WegenerPiat/stm32f4-energy-monitor/proto_mesure/liste_composant.ods

Nom du composant | Valeur | Information complémentaire | Quantité | Prix à l’unité | Prix total | Référence farnell | Référence Fabricant | Fabricant
Capacité | 100nF | traversant et ceramique | 3 | 0,1782 | 0,5346 | 1216440 | MCRR50104X7RK0050 | Multicomp
LED |  | 3mm | 1 | 0 | 0
Connecteur 01x05 |  | Barrette secable embase mâle (40 contacts) | 3 | 2,17 | 2,17 | 1098454 | 4-103321-8. | TE Connectivity
Bornier 01x05 |  | Pas 5.08 | 2 | 1,42 | 2,84 | 2008007 | MC000037 | Multicomp
Résistance | 680R | traversante | 1 | 0,0714 | 0,0714 | 9338926 | MCF 0.5W 680R | Multicomp
Shunt |  | 0.02 ohm (choix non definitif) | 4 | 3,17 | 12,68 | 2408840 | LVR03R0200FE12 | VISHAY
Shield NUCLEO |  |  | 1 | 13,36 | 13,36 | 2491978 | NUCLEO-F446RE | STMicroelectronics
MAX4377 |  | ampli diff. Gain : 20 | 2 | 2,63 | 5,26 | 2515271 | MAX4377TAUA+ | MAXIM
 |  |  |  | Prix final : | 36,916
