WegenerPiat/stm32f4-energy-monitor/(list of files, drawings)

Other design files:
proto_mesure/MB1136C_schematic_layout/Connectors.SchDoc
proto_mesure/MB1136C_schematic_layout/MB1136.PcbDoc
proto_mesure/MB1136C_schematic_layout/MB1136.PrjPCB
proto_mesure/MB1136C_schematic_layout/MB1136.SchDoc
proto_mesure/MB1136C_schematic_layout/MB1136.SCHLIB
proto_mesure/MB1136C_schematic_layout/MCU_64.SchDoc
proto_mesure/MB1136C_schematic_layout/ST_LINK_V2-1.SCHDOC
