WegenerPiat/stm32f4-energy-monitor/proto_mesure/kicad/carte_mesure.kicad_pcb

## KiCad design proto_mesure/kicad/carte_mesure.kicad_pcb (2016-08-31)

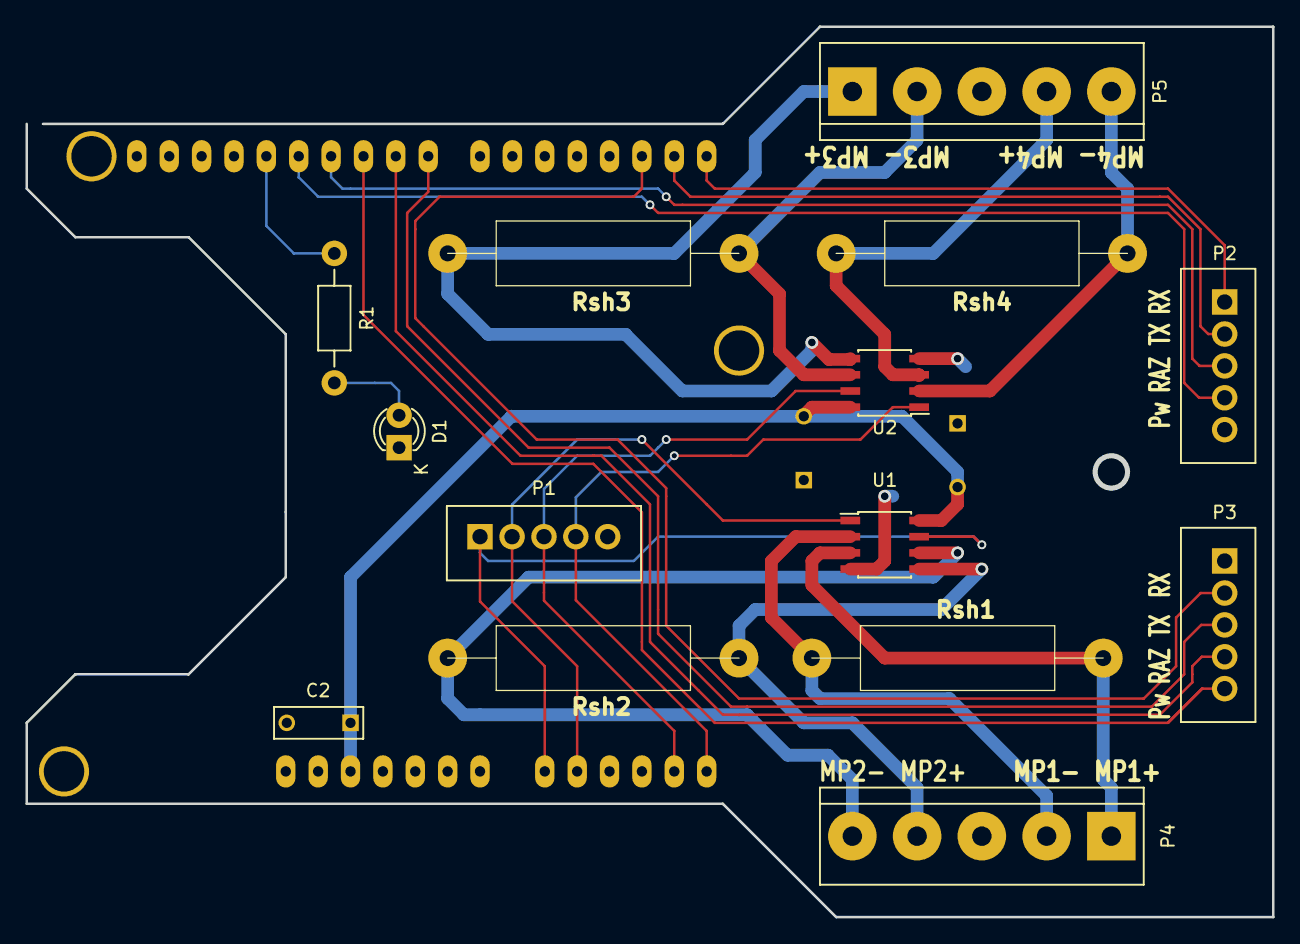
[picture p1: board carte_mesure.kicad_pcb from above]

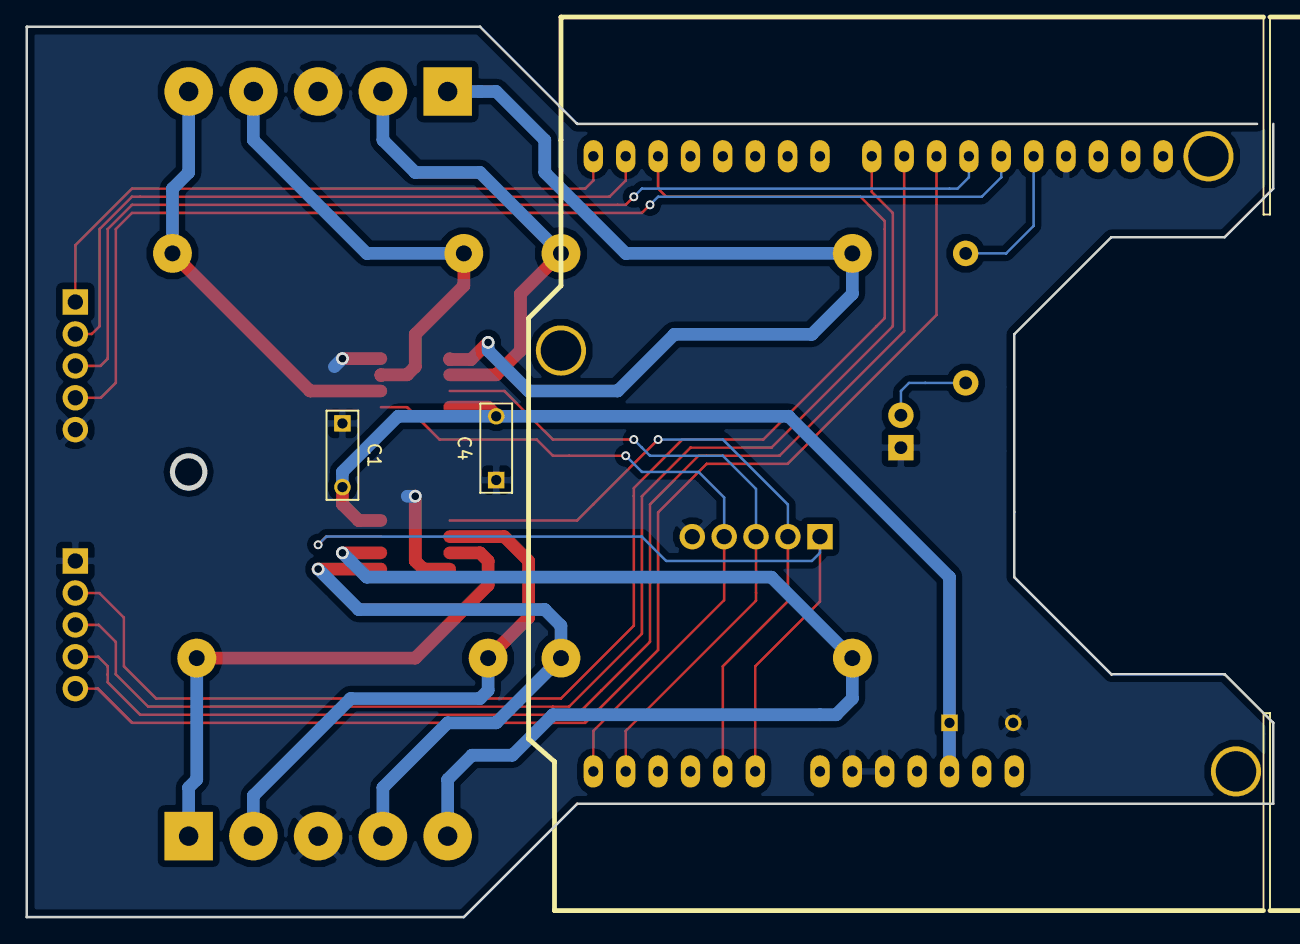
[picture p2: board carte_mesure.kicad_pcb from below]

Board: 2 copper layers, 97.8 x 69.8 mm, 17 parts (2 on the bottom side), 24 nets.

Parts:
C1, C2, C4: 100nF; C_Rect_L7_W2.5_P5
D1: LED; LED-3MM
P1, P2, P3: CONN_01X05; Wafer_Vertical15x5.8x7RM2.5-5
P4, P5: CONN_01X05; bornier5
R1: 680R; Resistor_Horizontal_RM10mm
Rsh1, Rsh2, Rsh3, Rsh4: Shunt; shunt
SHIELD1: ARDUINO_SHIELD_NUCLEO
U1, U2: MAX4377; SOIC-8_3.9x4.9mm_Pitch1.27mm

Connections:
+3V3: C1.2, C2.1, C4.2, SHIELD1.3V3, U1.8, U2.8
/carte_nucleo/MP_A1: P1.1, SHIELD1.AD0, U1.7
/carte_nucleo/MP_A2: P1.2, SHIELD1.AD1, U1.1
/carte_nucleo/MP_B1: P1.3, SHIELD1.AD4, U2.7
/carte_nucleo/MP_B2: P1.4, SHIELD1.AD5, U2.1
/carte_nucleo/PWD1: P2.4, SHIELD1.D12
/carte_nucleo/PWD2: P3.5, SHIELD1.D10
/carte_nucleo/RX1: P2.1, SHIELD1.D0
/carte_nucleo/RX2: P3.2, SHIELD1.D2
/carte_nucleo/Reset1: P2.3, SHIELD1.D11
/carte_nucleo/Reset2: P3.4, SHIELD1.D9
/carte_nucleo/TX1: P2.2, SHIELD1.D1
/carte_nucleo/TX2: P3.3, SHIELD1.D8
/conn_shunt1/MP1+: P4.1, Rsh1.+, U1.3
/conn_shunt1/MP1-: P4.2, Rsh1.-, U1.2
/conn_shunt1/MP2+: P4.4, Rsh2.+, U1.5
/conn_shunt1/MP2-: P4.5, Rsh2.-, U1.6
/conn_shunt_MES2/MP3+: P5.1, Rsh3.+, U2.5
/conn_shunt_MES2/MP3-: P5.2, Rsh3.-, U2.6
/conn_shunt_MES2/MP4+: P5.4, Rsh4.+, U2.3
/conn_shunt_MES2/MP4-: P5.5, Rsh4.-, U2.2
GND: C1.1, C2.2, C4.1, D1.1, P1.5, P2.5, P3.1, P4.3, P5.3, SHIELD1.GND1, SHIELD1.GND2, SHIELD1.GND3, U1.4, U2.4
unnamed: D1.2, R1.2
unnamed: R1.1, SHIELD1.D13
