WegenerPiat/stm32f4-energy-monitor/firmware/src/energy_monitor.c

#include <stdlib.h>
#include <libopencm3/stm32/rcc.h>
#include <libopencm3/stm32/gpio.h>
#include <libopencm3/stm32/adc.h>
#include <libopencm3/stm32/timer.h>
#include <libopencm3/usb/usbd.h>
#include <libopencm3/usb/cdc.h>
#include <libopencm3/cm3/scb.h>
#include <libopencm3/cm3/nvic.h>
#include <libopencm3/cm3/systick.h>
#include <libopencm3/stm32/dma.h>
#include <libopencm3/stm32/flash.h>
#include <libopencm3/stm32/exti.h>
#include <libopencm3/stm32/pwr.h>

// USB Code

static const struct usb_device_descriptor dev = {
    .bLength = USB_DT_DEVICE_SIZE,
    .bDescriptorType = USB_DT_DEVICE,
    .bcdUSB = 0x0200,
    .bDeviceClass = 0,
    .bDeviceSubClass = 0,
    .bDeviceProtocol = 0,
    .bMaxPacketSize0 = 64,
    .idVendor = 0xF539,
    .idProduct = 0xF539,
    .bcdDevice = 0x0200,
    .iManufacturer = 1,
    .iProduct = 2,
    .iSerialNumber = 3,
    .bNumConfigurations = 1,
};


static const struct usb_endpoint_descriptor data_endp[] = {{
    .bLength = USB_DT_ENDPOINT_SIZE,
    .bDescriptorType = USB_DT_ENDPOINT,
    .bEndpointAddress = 0x81,
    .bmAttributes = USB_ENDPOINT_ATTR_BULK,
    .wMaxPacketSize = 64,
    .bInterval = 1,
}, {
    .bLength = USB_DT_ENDPOINT_SIZE,
    .bDescriptorType = USB_DT_ENDPOINT,
    .bEndpointAddress = 0x82,
    .bmAttributes = USB_ENDPOINT_ATTR_INTERRUPT,
    .wMaxPacketSize = 64,
    .bInterval = 1,
}};

static const struct usb_interface_descriptor data_iface[] = {{
    .bLength = USB_DT_INTERFACE_SIZE,
    .bDescriptorType = USB_DT_INTERFACE,
    .bInterfaceNumber = 0,
    .bAlternateSetting = 0,
    .bNumEndpoints = 2,
    .bInterfaceClass = 0xFF,
    .bInterfaceSubClass = 0,
    .bInterfaceProtocol = 0,
    .iInterface = 2,

    .endpoint = data_endp,
}};

static const struct usb_interface ifaces[] = {{
    .num_altsetting = 1,
    .altsetting = data_iface,
}};

static const struct usb_config_descriptor config = {
    .bLength = USB_DT_CONFIGURATION_SIZE,
    .bDescriptorType = USB_DT_CONFIGURATION,
    .wTotalLength = 0,
    .bNumInterfaces = 1,
    .bConfigurationValue = 1,
    .iConfiguration = 0,
    .bmAttributes = 0x80,
    .bMaxPower = 0x32,

    .interface = ifaces,
};

static const char *serial_str = (const char*)0x08004000;

static const char *usb_strings[] = {
    "James Pallister",
    "Medium speed energy monitor",
    0x08004000,
};

void adc_setup();
void error_condition();

// Power data ///////////////////////////////////////////////////////

#define INSTANT_AVG_BITS    5
#define INSTANT_AVG_NUM     (1<<INSTANT_AVG_BITS)
#define SIZE_BUFF 			50			//taille du buffer

typedef struct {
    uint64_t energy_accum;
    uint64_t elapsed_time;
    unsigned peak_power;
    unsigned peak_voltage;
    unsigned peak_current;
    unsigned n_samples;
    uint64_t test_tension;
    uint64_t avg_voltage;
} accumulated_data;

typedef struct {
    unsigned voltage;
    unsigned current;

    uint64_t current_time;    
} instant_data;

int tperiod=500;

typedef struct {
    accumulated_data accum_data;
    instant_data id;


    int idx;
    int running; // Are we collecting measurements
    int number_of_runs;

    // Implement a circular buffer in data_bufs
    int trigger_port, trigger_pin;

    int assigned_adc;

    unsigned short lastI, lastV;
    unsigned lastP;

    unsigned short avgI[INSTANT_AVG_NUM], avgV[INSTANT_AVG_NUM];
    unsigned short avg_ptr;

    unsigned char chans[1];
} measurement_point;

/////////buffer circulaire/////////
typedef struct {	
	uint64_t *buffer_complete;		//totalite du buffer
	uint64_t *read_bc;				//pointeur de lecture
	uint64_t *write_bc;				//pointeur d ecriture
	
	uint64_t *debut;				//pointeur de debut
	uint64_t *fin;					//pointeur de fin

	int nb_read;					//nombre de donnee envoyee
	int nb_write;					//nombre de donnee ecrite
} buff;

measurement_point m_points[4] = {0};
buff bc;

int adc_to_mpoint[3] = {-1, -1, -1};

// USB communication globals ////////////////////////////////////////
usbd_device *usbd_dev;

uint8_t control_buffer[128] __attribute__((aligned (16)));

unsigned versionNumber=14;

/////////////////////////////////////////////////////////////////////

void exti_setup(int m_point)
{
    int i;

    nvic_disable_irq(NVIC_EXTI0_IRQ);
    nvic_disable_irq(NVIC_EXTI1_IRQ);
    nvic_disable_irq(NVIC_EXTI2_IRQ);
    nvic_disable_irq(NVIC_EXTI3_IRQ);
    nvic_disable_irq(NVIC_EXTI4_IRQ);
    nvic_disable_irq(NVIC_EXTI9_5_IRQ);
    nvic_disable_irq(NVIC_EXTI15_10_IRQ);
    exti_reset_request(EXTI0 | EXTI1 | EXTI2 | EXTI3 | EXTI4 | EXTI5 | EXTI6  | EXTI7
            | EXTI8 | EXTI9 | EXTI10 | EXTI11 | EXTI12 | EXTI13 | EXTI14  | EXTI15);

    for(i = 0; i < 4; ++i)
    {
        exti_select_source(m_points[i].trigger_pin, m_points[i].trigger_port);
        exti_set_trigger(m_points[i].trigger_pin, EXTI_TRIGGER_BOTH);
        exti_enable_request(m_points[i].trigger_pin);
        gpio_mode_setup(m_points[i].trigger_port, GPIO_MODE_INPUT, GPIO_PUPD_NONE, m_points[i].trigger_pin);

        switch(m_points[i].trigger_pin)
        {
            case 1<<0: nvic_enable_irq(NVIC_EXTI0_IRQ); break;
            case 1<<1: nvic_enable_irq(NVIC_EXTI1_IRQ); break;
            case 1<<2: nvic_enable_irq(NVIC_EXTI2_IRQ); break;
            case 1<<3: nvic_enable_irq(NVIC_EXTI3_IRQ); break;
            case 1<<4: nvic_enable_irq(NVIC_EXTI4_IRQ); break;
            case 1<<5:
            case 1<<6:
            case 1<<7:
            case 1<<8:
            case 1<<9: nvic_enable_irq(NVIC_EXTI9_5_IRQ); break;
            case 1<<10:
            case 1<<11:
            case 1<<12:
            case 1<<13:
            case 1<<14:
            case 1<<15: nvic_enable_irq(NVIC_EXTI15_10_IRQ); break;
        }
    }
}


/////////////// Buffer circulaire ///////////
/* fonction d initialisation du buffer */

void init_Buff()
{
	bc.buffer_complete = NULL;

	bc.buffer_complete = malloc(SIZE_BUFF * sizeof(uint64_t));	//creation du buffer
	
	if(bc.buffer_complete == NULL)		//test validite
	{
		exit(0);
	}

	bc.debut = bc.buffer_complete;
	bc.fin = bc.buffer_complete + SIZE_BUFF;

	bc.read_bc = bc.debut;
	bc.write_bc = bc.debut + 1;

	bc.nb_write = 0;
	bc.nb_read = 0;

}

/* fonction pour rendre la memoire */
void buff_free()
{
	free(bc.buffer_complete);	// On rend la place
}


/* 

cas 1: write et read non passer
cas 2: write passer read non passer

*/
int write_buff(int m_point)		//rajouter la donnee
{

	if((bc.nb_write % (SIZE_BUFF/2)) >= (bc.nb_read % (SIZE_BUFF/2)))
	{
		// cas 1: write et read non passer

		
		if(bc.nb_write >= (bc.nb_read + (SIZE_BUFF/2)))	// test buff plein
		{											// ne peut jamais
			return(0);								// ici normalement
		}
	
		*bc.write_bc = m_points[m_point].lastV;	//valeur de l'adc

		bc.nb_write++;							//on incremente l ecriture
		if(bc.write_bc >= bc.fin)				//Si write arrive a la fin
		{
			bc.write_bc = bc.debut;
		}else
			bc.write_bc ++;
	}else
	{
		//cas 2: write passer, read non passer
		if(bc.nb_write >= (bc.nb_read + (SIZE_BUFF/2)))		//test buff plein
		{
			return(0);
		}
	
		*bc.write_bc = m_points[m_point].lastV;	//valeur de l'adc
		bc.write_bc ++;

		bc.nb_write++;							//on incremente l ecriture
	}
	return(0);
}

/* fonction de test de lecture */
int read_buff(int m_point)
{
	if((bc.nb_write % (SIZE_BUFF/2)) >= (bc.nb_read % (SIZE_BUFF/2)))
	{

		// cas 1: write et read non passer

		if(bc.nb_read >= bc.nb_write)
		{
			return(0);
		}
		
		m_points[m_point].accum_data.test_tension = *bc.read_bc;	//valeur a envoyer

		bc.nb_read++;												//on incremente le compteur

		if(bc.read_bc >= bc.fin)
		{
			bc.read_bc = bc.debut;
		}else
			bc.read_bc ++;
	}else
	{
		//cas 2: write passer, read non passer
	
		m_points[m_point].accum_data.test_tension = *bc.read_bc;	//valeur a envoyer
		bc.read_bc ++;		//pas de probleme de fin du buffer

		bc.nb_read++;												//on incremente le compteur
	}
	return(0);
}


////////////////////////////////////////////////////////////////////////////////


void start_measurement(int m_point)
{
    m_points[m_point].running = 1;

    m_points[m_point].accum_data.energy_accum = 0;
    m_points[m_point].accum_data.elapsed_time = 0;
    m_points[m_point].accum_data.peak_power = 0;
    m_points[m_point].accum_data.peak_voltage = 0;
    m_points[m_point].accum_data.peak_current = 0;
    m_points[m_point].accum_data.n_samples = 0;
    m_points[m_point].accum_data.avg_voltage = 0;
    m_points[m_point].accum_data.test_tension = 0;
    m_points[m_point].lastP = 0;
	

	init_Buff();						// init buffer

    m_points[m_point].id.current_time = 0;

    switch(m_points[m_point].assigned_adc)
    {
        case 0:
            adc_set_regular_sequence(ADC1, 1, m_points[m_point].chans);
            adc_power_on(ADC1);
            break;
        case 1:
            adc_set_regular_sequence(ADC2, 1, m_points[m_point].chans);
            adc_power_on(ADC2);
            break;
        case 2:
            adc_set_regular_sequence(ADC3, 1, m_points[m_point].chans);
            adc_power_on(ADC3);
            break;
        case -1:
            error_condition(); return;
        default:
            error_condition(); return;
    }
}

void stop_measurement(int m_point)
{
    m_points[m_point].running = 0;
    m_points[m_point].number_of_runs++;

    switch(m_points[m_point].assigned_adc)
    {
        case 0: adc_off(ADC1); break;
        case 1: adc_off(ADC2); break;
        case 2: adc_off(ADC3); break;
        case -1:
            error_condition(); return;
        default:
            error_condition(); return;
    }
	buff_free();			//rendu de la mémoire
}

void flash_serial(char b1, char b2, char b3, char b4)
{
    uint32_t base_addr = (uint32_t) serial_str;

    flash_unlock();
    flash_erase_sector(1, FLASH_CR_PROGRAM_X32);

    flash_program_byte(base_addr+0, b1);
    flash_program_byte(base_addr+1, b2);
    flash_program_byte(base_addr+2, b3);
    flash_program_byte(base_addr+3, b4);

    flash_program_byte(base_addr+4, 0x0);
    flash_lock();
}


static int usbdev_control_request(usbd_device *usbd_dev, struct usb_setup_data *req, uint8_t **buf,
        uint16_t *len, void (**complete)(usbd_device *usbd_dev, struct usb_setup_data *req))
{
    int i;

    (void)complete;
    (void)buf;
    (void)usbd_dev;

    switch (req->bRequest) {
    case 0:     // toggle LEDS
        gpio_toggle(GPIOD, GPIO13);
        *len = 0;
        break;
    case 1:     // Start
    {
        gpio_set(GPIOD, GPIO12);

        start_measurement(req->wValue-1);
        *len = 0;
        break;
    }
    case 2:     // Stop
    {
        gpio_clear(GPIOD, GPIO12);
        stop_measurement(req->wValue-1);
        *len = 0;
        break;
    }
    case 3:     // Set serial
    {
        if(*len != 0)
            return 0;

        flash_serial(req->wValue & 0xFF, req->wValue >> 8, req->wIndex & 0xFF, req->wIndex >> 8);

        break;
    }
    case 4:     // Set Trigger
    {
        if(*len != 0)
            return 0;

        int m_point = (req->wValue >> 8) - 1;

        gpio_toggle(GPIOD, GPIO14);

        switch(req->wValue & 0xFF)
        {
            case 'A': m_points[m_point].trigger_port = GPIOA; break;
            case 'B': m_points[m_point].trigger_port = GPIOB; break;
            case 'C': m_points[m_point].trigger_port = GPIOC; break;
            case 'D': m_points[m_point].trigger_port = GPIOD; break;
            case 'E': m_points[m_point].trigger_port = GPIOE; break;
            case 'F': m_points[m_point].trigger_port = GPIOF; break;
            case 'G': m_points[m_point].trigger_port = GPIOG; break;
            case 'H': m_points[m_point].trigger_port = GPIOH; break;
            default:
                m_points[m_point].trigger_port = -1; break;
        }

        m_points[m_point].trigger_pin = 1 << (req->wIndex & 0xFF);

        if(m_points[m_point].trigger_port != GPIOA)
            gpio_toggle(GPIOD, GPIO12);

        exti_setup(m_point);
        break;
    }
    case 6:     // Get energy
    {
		read_buff(req->wValue-1);
        *len = sizeof(accumulated_data);
        *buf = (uint8_t*)&m_points[req->wValue-1].accum_data;
        break;
    }
    case 7:     // Map ADC to measurement point
    {
        int adc = req->wIndex;
        int m_point = req->wValue - 1;

        m_points[m_point].assigned_adc = adc;
        adc_to_mpoint[adc] = m_point;
        break;
    }
    case 8:     // Is running
    {
        *len = sizeof(m_points[req->wValue-1].running);
        *buf = (uint8_t*)&m_points[req->wValue-1].running;
        break;
    }
    case 9:     // Get number of runs
    {
        *len = sizeof(m_points[req->wValue-1].number_of_runs);
        *buf = (uint8_t*)&m_points[req->wValue-1].number_of_runs;
        break;
    }
    case 10:    // Clear number of runs
    {
        m_points[req->wValue-1].number_of_runs = 0;
        break;
    }
    case 11:    // Get instantaneous
    {
        int m_point = req->wValue - 1;
        int  tot_voltage = 0, i;
        measurement_point *mp = &m_points[m_point];

        mp->id.voltage = mp->lastV;

        for(i = 0; i < INSTANT_AVG_NUM; ++i)
        {
            tot_voltage += mp->avgV[i];
        }


        mp->id.current_time = mp->accum_data.elapsed_time;

        *len = sizeof(instant_data);
        *buf = (uint8_t*)&m_points[req->wValue-1].id;
        break;
    }
    case 12:    // Get version
    {
        *len = sizeof(versionNumber);
        *buf = (uint8_t*)&versionNumber;
        break;
    }
    case 13:    // Get serial
    {
        *len = 4;
        *buf = (uint8_t*)serial_str;
        break;
    }

    default:
        return 0;
    }
    return 1;
}

static void usb_reset_cb()
{
    int i;

    for(i = 0; i < 4; ++i)
    {
        m_points[i].running = 0;
        m_points[i].trigger_port = -1;
        m_points[i].trigger_pin = -1;
        m_points[i].assigned_adc = -1;
    }
}

static void usbdev_set_config(usbd_device *usbd_dev, uint16_t wValue)
{
    (void)wValue;

    usbd_ep_setup(usbd_dev, 0x81, USB_ENDPOINT_ATTR_BULK, 64, NULL);
    usbd_ep_setup(usbd_dev, 0x82, USB_ENDPOINT_ATTR_INTERRUPT, 64, NULL);

    usbd_register_control_callback(
                usbd_dev,
                USB_REQ_TYPE_VENDOR | 3,
                USB_REQ_TYPE_TYPE | USB_REQ_TYPE_RECIPIENT,
                usbdev_control_request);

    usbd_register_reset_callback(usbd_dev, usb_reset_cb);
}

void timer_setup()
{
    rcc_peripheral_enable_clock(&RCC_APB1ENR, RCC_APB1ENR_TIM2EN);

    timer_disable_counter(TIM2);
    timer_reset(TIM2);
    timer_set_mode(TIM2, TIM_CR1_CKD_CK_INT, TIM_CR1_CMS_EDGE, TIM_CR1_DIR_UP);
    timer_set_period(TIM2, tperiod);
    timer_set_prescaler(TIM2, 0);
    timer_set_clock_division(TIM2, TIM_CR1_CKD_CK_INT);
    timer_set_master_mode(TIM2, TIM_CR2_MMS_UPDATE);
    timer_enable_preload(TIM2);
    timer_enable_counter(TIM2);
}

void adc_setup()
{
    gpio_mode_setup(GPIOC, GPIO_MODE_ANALOG, GPIO_PUPD_NONE, GPIO1 | GPIO2 | GPIO4 | GPIO5);
    rcc_peripheral_enable_clock(&RCC_APB2ENR, RCC_APB2ENR_ADC1EN);
    rcc_peripheral_enable_clock(&RCC_APB2ENR, RCC_APB2ENR_ADC2EN);
    rcc_peripheral_enable_clock(&RCC_APB2ENR, RCC_APB2ENR_ADC3EN);
    rcc_peripheral_reset(&RCC_APB2ENR, RCC_APB2RSTR_ADCRST);
    adc_off(ADC1);
    adc_off(ADC2);
    adc_off(ADC3);

    ADC_CCR = 0;
    ADC1_CR1 = 0;
    ADC2_CR1 = 0;
    ADC3_CR1 = 0;
    ADC1_CR2 = 0;
    ADC2_CR2 = 0;
    ADC3_CR2 = 0;

    adc_set_single_conversion_mode(ADC1);
    adc_set_single_conversion_mode(ADC2);
    adc_set_single_conversion_mode(ADC3);

    // Input 1
    uint8_t channels1[] = {14};   // CH2 Voltage, PC4, ADC12
    uint8_t channels2[] = {15};   // CH2 Voltage, PC5, ADC12
    uint8_t channels3[] = {12};   // CH2 Voltage, PC2, ADC123
    uint8_t channels4[] = {11};   // CH2 Voltage, PC1, ADC123

    adc_set_sample_time_on_all_channels(ADC1, ADC_SMPR_SMP_15CYC);
    adc_set_sample_time_on_all_channels(ADC2, ADC_SMPR_SMP_15CYC);
    adc_set_sample_time_on_all_channels(ADC3, ADC_SMPR_SMP_15CYC);
    adc_enable_external_trigger_regular(ADC1,ADC_CR2_EXTSEL_TIM2_TRGO, ADC_CR2_EXTEN_RISING_EDGE);
    adc_enable_external_trigger_regular(ADC2,ADC_CR2_EXTSEL_TIM2_TRGO, ADC_CR2_EXTEN_RISING_EDGE);
    adc_enable_external_trigger_regular(ADC3,ADC_CR2_EXTSEL_TIM2_TRGO, ADC_CR2_EXTEN_RISING_EDGE);

    adc_set_resolution(ADC1, ADC_CR1_RES_12BIT);
    adc_set_resolution(ADC2, ADC_CR1_RES_12BIT);
    adc_set_resolution(ADC3, ADC_CR1_RES_12BIT);

    adc_set_right_aligned(ADC1);
    adc_set_right_aligned(ADC2);
    adc_set_right_aligned(ADC3);

    adc_enable_overrun_interrupt(ADC1);
    adc_enable_overrun_interrupt(ADC2);
    adc_enable_overrun_interrupt(ADC3);

    adc_enable_eoc_interrupt(ADC1);
    adc_enable_eoc_interrupt(ADC2);
    adc_enable_eoc_interrupt(ADC3);
    adc_eoc_after_each(ADC1);
    adc_eoc_after_each(ADC2);
    adc_eoc_after_each(ADC3);

    nvic_set_priority(NVIC_ADC_IRQ, 0x10);
    nvic_enable_irq(NVIC_ADC_IRQ);
}

void exti_timer_setup()
{
    // Timer is used for deboucing (is it?)
    // If output on trigger is the same 3ms later, accept as input
    rcc_peripheral_enable_clock(&RCC_APB1ENR, RCC_APB1ENR_TIM3EN);
    timer_reset(TIM3);
    timer_set_mode(TIM3, TIM_CR1_CKD_CK_INT, TIM_CR1_CMS_EDGE, TIM_CR1_DIR_UP);
    timer_set_period(TIM3, 300);
    timer_set_prescaler(TIM3, 1679);
    timer_set_clock_division(TIM3, TIM_CR1_CKD_CK_INT);
    timer_set_master_mode(TIM3, TIM_CR2_MMS_UPDATE);
    timer_enable_irq(TIM3, TIM_DIER_UIE);

    nvic_set_priority(NVIC_TIM3_IRQ, 0x30);
    nvic_enable_irq(NVIC_TIM3_IRQ);

    nvic_set_priority(NVIC_EXTI0_IRQ, 0x40);
    nvic_set_priority(NVIC_EXTI1_IRQ, 0x40);
    nvic_set_priority(NVIC_EXTI2_IRQ, 0x40);
    nvic_set_priority(NVIC_EXTI3_IRQ, 0x40);
    nvic_set_priority(NVIC_EXTI4_IRQ, 0x40);
    nvic_set_priority(NVIC_EXTI9_5_IRQ, 0x40);
    nvic_set_priority(NVIC_EXTI15_10_IRQ, 0x40);
}

// This should probably reset the board and tell the user
void error_condition()
{
    gpio_set(GPIOD, GPIO15);
    while(1);
}

int main(void)
{
    int c_started=0, n, cpy, i, offset=0;
    short s;

    rcc_clock_setup_hse_3v3(&hse_8mhz_3v3[CLOCK_3V3_168MHZ]);

    rcc_peripheral_enable_clock(&RCC_AHB1ENR, RCC_AHB1ENR_DMA2EN);
    rcc_peripheral_enable_clock(&RCC_AHB1ENR, RCC_AHB1ENR_IOPAEN);
    rcc_peripheral_enable_clock(&RCC_AHB1ENR, RCC_AHB1ENR_IOPBEN);
    rcc_peripheral_enable_clock(&RCC_AHB1ENR, RCC_AHB1ENR_IOPCEN);
    rcc_peripheral_enable_clock(&RCC_AHB1ENR, RCC_AHB1ENR_IOPDEN);
    rcc_peripheral_enable_clock(&RCC_AHB2ENR, RCC_AHB2ENR_OTGFSEN);

    // First want to check our serial. If not set, set it
    // Probably want to check that these are alphanumeric as well
    if(!isalnum(serial_str[0]) || !isalnum(serial_str[1]) || !isalnum(serial_str[2]) || !isalnum(serial_str[3]))
    {
        flash_serial('E', 'E', '0', '0');
    }

    // 1ms tick
    systick_set_reload(168000);
    systick_set_clocksource(STK_CSR_CLKSOURCE);
    systick_counter_enable();
    nvic_set_priority(NVIC_SYSTICK_IRQ, 0xFF);
    systick_interrupt_enable();

    gpio_mode_setup(GPIOA, GPIO_MODE_AF, GPIO_PUPD_NONE, GPIO9 | GPIO11 | GPIO12);
    gpio_mode_setup(GPIOD, GPIO_MODE_OUTPUT, GPIO_PUPD_NONE, GPIO15 | GPIO14 | GPIO13 | GPIO12);
    gpio_set_af(GPIOA, GPIO_AF10, GPIO9 | GPIO11 | GPIO12);

    for(i = 0;i < 4; ++i)
    {
        m_points[i].assigned_adc = -1;
        m_points[i].trigger_port = -1;
        m_points[i].trigger_pin = -1;
    }

    m_points[0].chans[0] = 14;	// sortie A PC4

    m_points[1].chans[0] = 15;	// sortie B PC5

    m_points[2].chans[0] = 12;	// sortie C PC2

    m_points[3].chans[0] = 11;	// sortie D PC1

    adc_setup();
    timer_setup();
    exti_timer_setup();

    gpio_toggle(GPIOA, GPIO12);


    usbd_dev = usbd_init(&otgfs_usb_driver, &dev, &config, usb_strings, 3, control_buffer, 128);
    usbd_register_set_config_callback(usbd_dev, usbdev_set_config);

    while (1)
    {
        usbd_poll(usbd_dev);
    }
}


int status = -1;

void exti0_isr () __attribute__ ((weak, alias ("exti_isr")));
void exti1_isr () __attribute__ ((weak, alias ("exti_isr")));
void exti2_isr () __attribute__ ((weak, alias ("exti_isr")));
void exti3_isr () __attribute__ ((weak, alias ("exti_isr")));
void exti4_isr () __attribute__ ((weak, alias ("exti_isr")));
void exti9_5_isr () __attribute__ ((weak, alias ("exti_isr")));
void exti15_10_isr () __attribute__ ((weak, alias ("exti_isr")));

void exti_isr()
{
    int i;

    for(i = 0; i < 4; ++i)
        exti_reset_request(m_points[i].trigger_pin);

    if(status == -1 || 1 )
    {
        for(i = 0; i < 4; ++i)
        {
            if(m_points[i].trigger_port == -1 || m_points[i].trigger_pin == -1)
                continue;

            if(gpio_get(m_points[i].trigger_port, m_points[i].trigger_pin))
            {
                if(!m_points[i].running)
                start_measurement(i);
            }
            else
            {
                if(m_points[i].running)
                    stop_measurement(i);
            }
        }

        // Timeout to ignore other spurious edges
        // status = gpio_get(trigger_port, trigger_pin);
        // timer_enable_counter(TIM3);
        // timer_set_counter(TIM3, 0);
    }
}

void tim3_isr()
{
    TIM_SR(TIM3) &= ~TIM_SR_UIF;
    timer_disable_counter(TIM3);
    status = -1;
}

void exit(int a)
{
    while(1);
}

void adc_isr()
{
    int m_point;
    measurement_point *mp;
    int adcs[3] = {ADC1, ADC2, ADC3};
    int i;

    for(i = 0; i < 3; ++i)
    {
        if(adc_get_overrun_flag(adcs[i]))
            error_condition();

        if(adc_eoc(adcs[i]))
        {
            unsigned short val;

            m_point = adc_to_mpoint[i];
            if(m_point == -1)
                error_condition();

            // Get measurement point & buffer
            mp = &m_points[m_point];

            // Read ADC
            val = ADC_DR(adcs[i]);

            // Save last value
            if(mp->idx&1)
            {
                mp->lastI = val;
                mp->avgI[mp->avg_ptr] = val;
                mp->avg_ptr = (mp->avg_ptr + 1) & (INSTANT_AVG_NUM - 1);
            }
            else
            {
                mp->lastV = val;
                mp->avgV[mp->avg_ptr] = val;
            }
	
            // Once we have read both current and voltage
            if((mp->idx & 1) == 1)
            {
                accumulated_data *a_data = &mp->accum_data;
                unsigned short c = mp->lastI;
                unsigned short v = mp->lastV;
                unsigned p = c*v;

                if(a_data->elapsed_time > 0) // ignore first sample (lastP = 0)
                {
                    a_data->energy_accum += (p + mp->lastP) / 2; // Trapezoidal integration;
                }

                mp->lastP = p;

                a_data->n_samples += 1;
                a_data->elapsed_time += tperiod;
                a_data->avg_voltage += v;
				//a_data->test_tension = mp->lastV;

				write_buff(m_point);

                if(p > a_data->peak_power)
                    a_data->peak_power = p;
                if(v > a_data->peak_voltage)
                    a_data->peak_voltage = v;
                if(c > a_data->peak_current)
                    a_data->peak_current = c;
            }

            mp->idx = 1-mp->idx;

            // HACK. Here we initialise the next channel to read from
            // because very occasionally the ADC seems to skip the next channel
            // suspect an odd timing bug, but only happens 1/10000000 times.
            unsigned char chan[1];

            // Select odd or even channel
            chan[0] = mp->chans[(mp->idx&1)];
            adc_set_regular_sequence(adcs[i], 1, chan);

            adc_enable_eoc_interrupt(adcs[i]);
        }
    }
}

int milliseconds = 0;

void sys_tick_handler()
{
    int state = 0;
    int flash=0;

    milliseconds++;

    // Compute state
    if(m_points[0].running || m_points[1].running || m_points[2].running || m_points[3].running)
    {
        state = 1;
        if(m_points[0].running)
            flash |= GPIO12;
        if(m_points[1].running)
            flash |= GPIO13;
        if(m_points[2].running)
            flash |= GPIO14;
        if(m_points[3].running)
            flash |= GPIO15;
    }

    if(state == 0)
    {
        gpio_clear(GPIOD, GPIO12 | GPIO13 | GPIO14 | GPIO15);
        if(milliseconds % 400 < 100)
            gpio_set(GPIOD, GPIO12);
        else if(milliseconds % 400 < 200)
            gpio_set(GPIOD, GPIO13);
        else if(milliseconds % 400 < 300)
            gpio_set(GPIOD, GPIO14);
        else
            gpio_set(GPIOD, GPIO15);
    }
    else if(state == 1)
    {
        if(milliseconds % 200 < 100)
            gpio_set(GPIOD, flash);
        else
            gpio_clear(GPIOD, GPIO12 | GPIO13 | GPIO14 | GPIO15);
    }
}
