WegenerPiat/stm32f4-energy-monitor/(commit log)

2016-08-31 fonctionnement pour la carte stm32_F4 Discovery avec le premier shield
2016-08-31 intégration du buffer, écriture des données dans un fichier texte
2016-08-31 intégration d'un tableau de données à transmettre et afficher. (ne fonctionne pas encore)
2016-08-31 ajout du dossier Kicad
    [Ampli.sch, Connectors.SchDoc, MB1136.PcbDoc, MB1136.PrjPCB, MB1136.SCHLIB, MB1136.SchDoc, MCU_64.SchDoc, ST_LINK_V2-1.SCHDOC]
